Velo-Volt/MicroMod_ESP32_Processor/Hardware/modified_files/SparkFun-ESP32MicroMod/SparkFun_MicroMod_ESP32_27012021.brd

## EAGLE design Hardware/modified_files/SparkFun-ESP32MicroMod/SparkFun_MicroMod_ESP32_27012021.brd (2021-01-27)

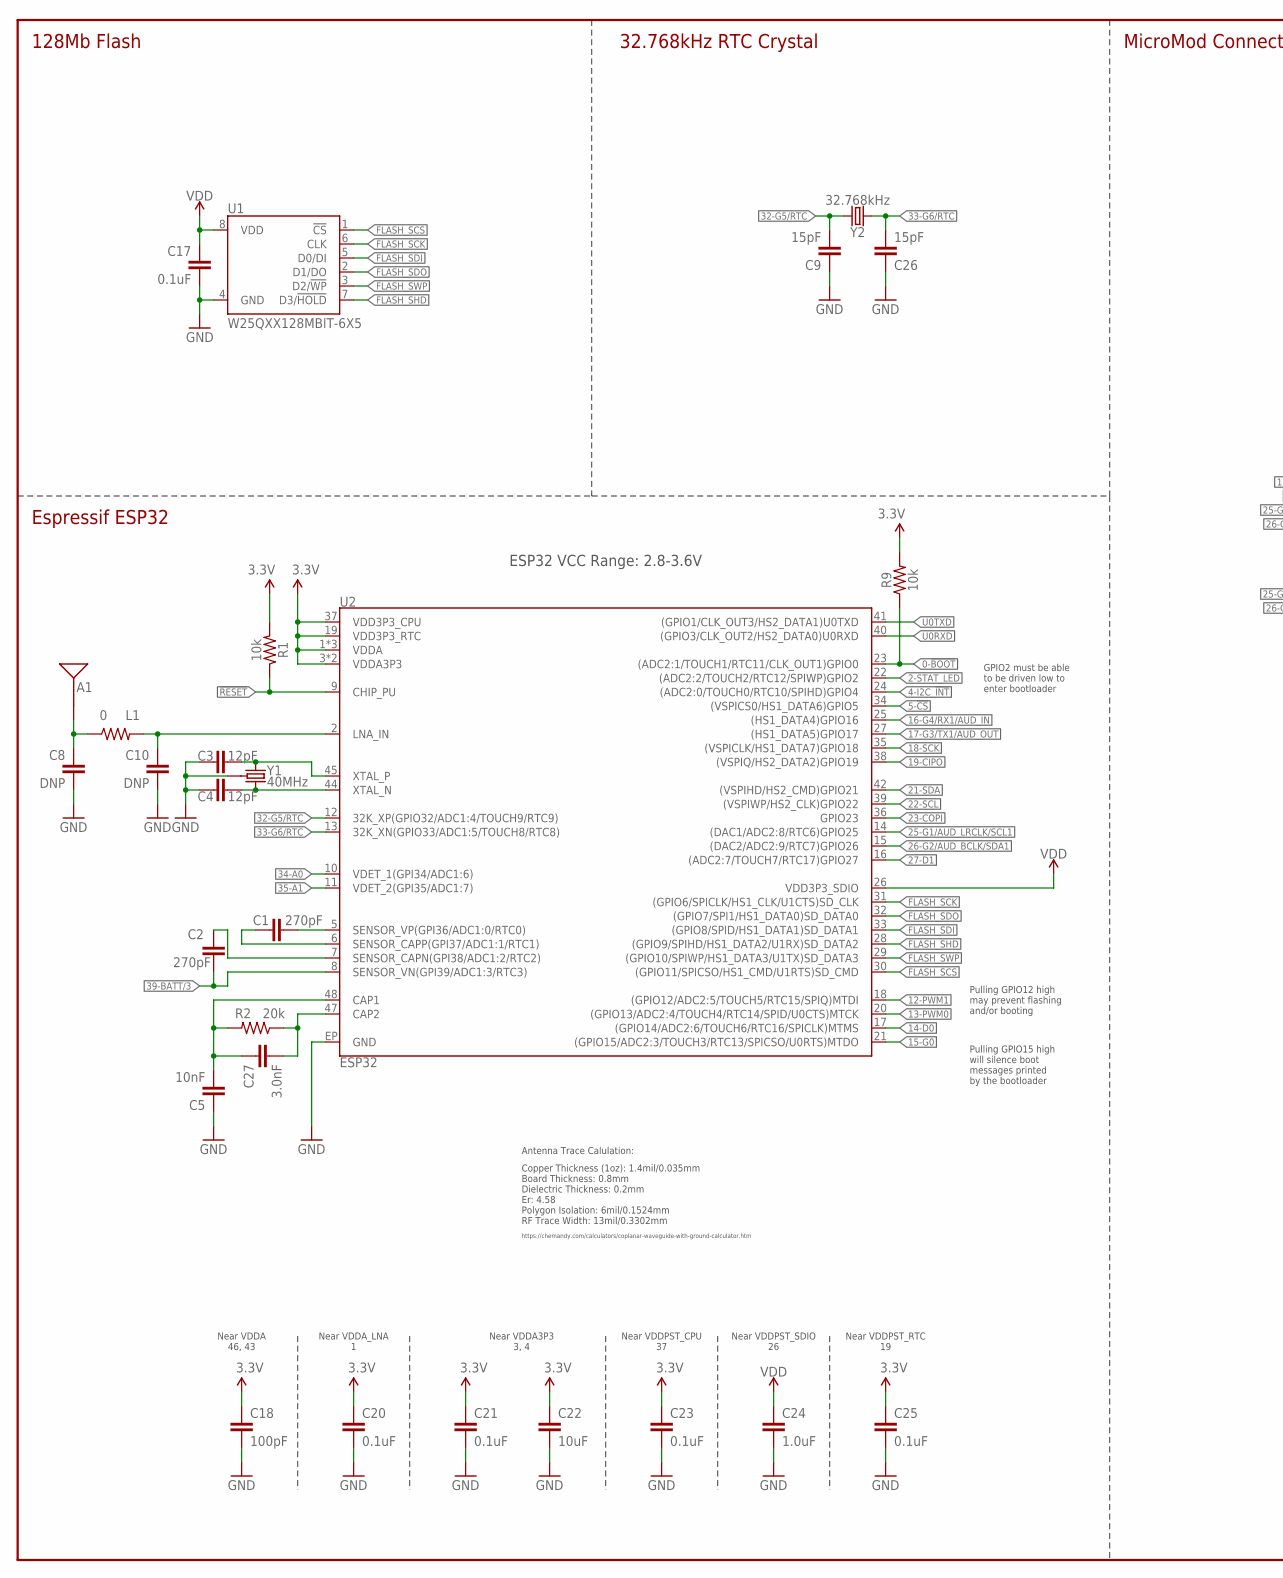
[picture p1: schematic SparkFun_MicroMod_ESP32_27012021.sch, part in row 1, column 1]

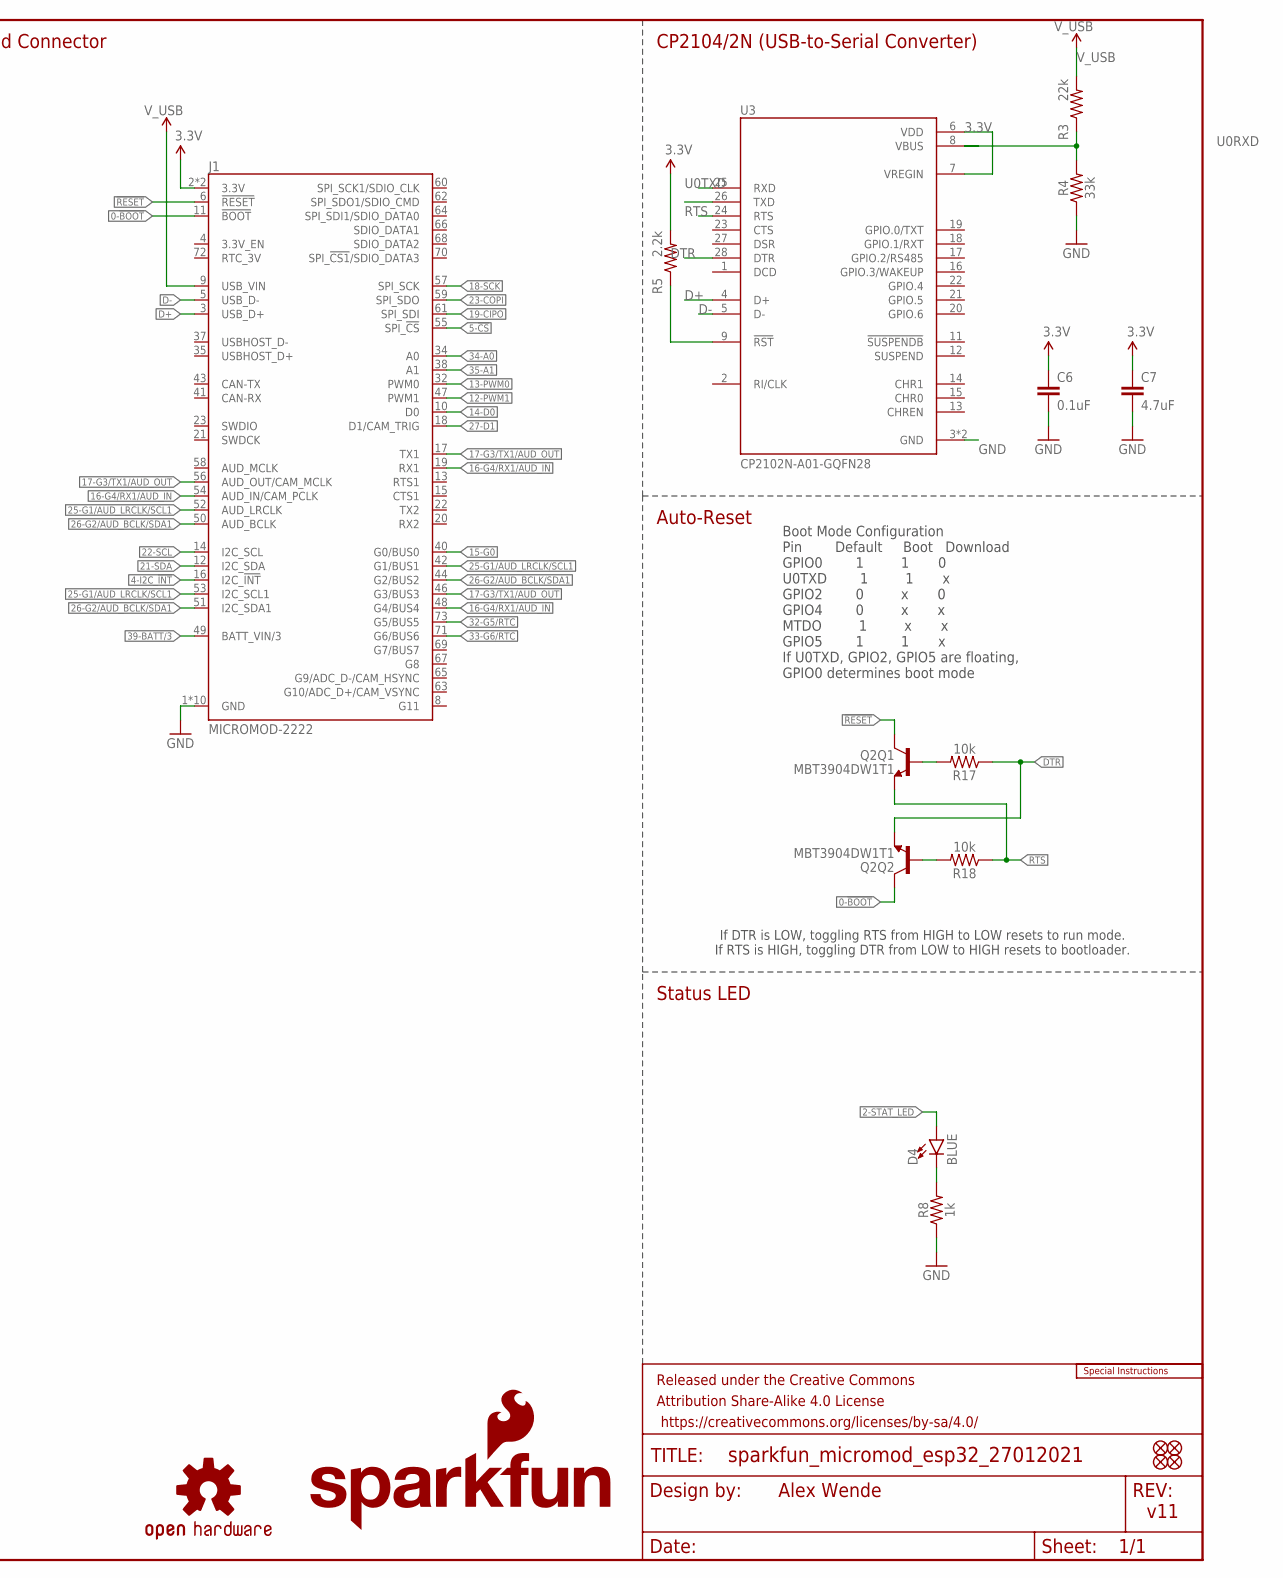
[picture p2: schematic SparkFun_MicroMod_ESP32_27012021.sch, part in row 1, column 2]

Parts:
A1: ANTENNA2.4GHZ-8.0X1.0MM; ANT-2.4GHZ-8.0X1.0MM
C1, C2: 270pF; 0402-TIGHT
C3, C4: 12pF; 0402-TIGHT
C5: 10nF; 0402-TIGHT
C6, C17, C20, C21, C23, C25: 0.1uF; 0402-TIGHT
C7: 4.7uF; 0402-TIGHT
C8, C10: DNP; 0402-TIGHT
C9, C26: 15pF; 0402-TIGHT
C18: 100pF; 0402-TIGHT
C22: 10uF; 0402-TIGHT
C24: 1.0uF; 0402-TIGHT
C27: 3.0nF; 0402-TIGHT
D4: BLUE; LED-0603
FD1, FD2, FD3, FD4: FIDUCIALUFIDUCIAL; FIDUCIAL-MICRO
FRAME1: FRAME-LEDGER; CREATIVE_COMMONS
J1: MICROMOD-2222; M.2-CARD-E-22
L1: 0; 0402-TIGHT
LOGO1: SPECIAL_INSTRUCTIONS-ORDERING; ORDERING_INSTRUCTIONS
LOGO2: SFE_LOGO_NAME_FLAME.1_INCH; SFE_LOGO_NAME_FLAME_.1
LOGO3: OSHW-LOGOS; OSHW-LOGO-S
Q2: MBT3904DW1T1; SC70-6
R1, R9, R17, R18: 10k; 0402-TIGHT
R2: 20k; 0402-TIGHT
R3: 22k; 0402-TIGHT
R4: 33k; 0402-TIGHT
R5: 2.2k; 0402-TIGHT
R8: 1k; 0402-TIGHT
U1: W25QXX128MBIT-6X5; WSON-8-6X5
U2: ESP32; QFN48-0.4MM
U3: CP2102N-A01-GQFN28; QFN50P500X500X80-29N
Y1: 40MHz; CRYSTAL-SMD-2X2.5MM
Y2: 32.768kHz; CRYSTAL-SMD-3.2X1.5MM

Connections:
0-!BOOT!: J1.11 (!BOOT!), Q2.6 (C), R9.1, U2.23 ((ADC2:1/TOUCH1/RTC11/CLK_OUT1)GPIO0)
2-STAT_LED: D4.A, U2.22 ((ADC2:2/TOUCH2/RTC12/SPIWP)GPIO2)
3.3V: C6.1, C7.1, C18.1, C20.1, C21.1, C22.1, C23.1, C25.1, J1.2 (3.3V), J1.74 (3.3V), R1.2, R5.2, R9.2, U2.1 (VDDA), U2.3 (VDDA3P3), U2.4 (VDDA3P3), U2.19 (VDD3P3_RTC), U2.37 (VDD3P3_CPU), U2.43 (VDDA), U2.46 (VDDA), U3.6 (VDD), U3.7 (VREGIN)
4-I2C_!INT: J1.16 (I2C_!INT!), U2.24 ((ADC2:0/TOUCH0/RTC10/SPIHD)GPIO4)
5-!CS: J1.55 (SPI_!CS!), U2.34 ((VSPICS0/HS1_DATA6)GPIO5)
12-PWM1: J1.47 (PWM1), U2.18 ((GPIO12/ADC2:5/TOUCH5/RTC15/SPIQ)MTDI)
13-PWM0: J1.32 (PWM0), U2.20 ((GPIO13/ADC2:4/TOUCH4/RTC14/SPID/U0CTS)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)
14-D0: J1.10 (D0), U2.17 ((GPIO14/ADC2:6/TOUCH6/RTC16/SPICLK)MTMS)
15-G0: J1.40 (G0/BUS0), U2.21 ((GPIO15/ADC2:3/TOUCH3/RTC13/SPICSO/U0RT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)
16-G4/RX1/AUD_IN: J1.19 (RX1), J1.48 (G4/BUS4), J1.54 (AUD_IN/CAM_PCLK), U2.25 ((HS1_DATA4)GPIO16)
17-G3/TX1/AUD_OUT: J1.17 (TX1), J1.46 (G3/BUS3), J1.56 (AUD_OUT/CAM_MCLK), U2.27 ((HS1_DATA5)GPIO17)
18-SCK: J1.57 (SPI_SCK), U2.35 ((VSPICLK/HS1_DATA7)GPIO18)
19-CIPO: J1.61 (SPI_SDI), U2.38 ((VSPIQ/HS2_DATA2)GPIO19)
21-SDA: J1.12 (I2C_SDA), U2.42 ((VSPIHD/HS2_CMD)GPIO21)
22-SCL: J1.14 (I2C_SCL), U2.39 ((VSPIWP/HS2_CLK)GPIO22)
23-COPI: J1.59 (SPI_SDO), U2.36 (GPIO23)
25-G1/AUD_LRCLK/SCL1: J1.42 (G1/BUS1), J1.52 (AUD_LRCLK), J1.53 (I2C_SCL1), U2.14 ((DAC1/ADC2:8/RTC6)GPIO25)
26-G2/AUD_BCLK/SDA1: J1.44 (G2/BUS2), J1.50 (AUD_BCLK), J1.51 (I2C_SDA1), U2.15 ((DAC2/ADC2:9/RTC7)GPIO26)
27-D1: J1.18 (D1/CAM_TRIG), U2.16 ((ADC2:7/TOUCH7/RTC17)GPIO27)
32-G5/RTC: C9.2, J1.73 (G5/BUS5), U2.12 (32K_XP(GPIO32/ADC1:4/TOUCH9/RTC9)), Y2.P$1 (1)
33-G6/RTC: C26.2, J1.71 (G6/BUS6), U2.13 (32K_XN(GPIO33/ADC1:5/TOUCH8/RTC8)), Y2.P$2 (2)
34-A0: J1.34 (A0), U2.10 (VDET_1(GPI34/ADC1:6))
35-A1: J1.38 (A1), U2.11 (VDET_2(GPI35/ADC1:7))
36: C1.2, U2.5 (SENSOR_VP(GPI36/ADC1:0/RTC0))
37: C1.1, U2.6 (SENSOR_CAPP(GPI37/ADC1:1/RTC1))
38: C2.1, U2.7 (SENSOR_CAPN(GPI38/ADC1:2/RTC2))
39-BATT/3: C2.2, J1.49 (BATT_VIN/3), U2.8 (SENSOR_VN(GPI39/ADC1:3/RTC3))
!RESET: J1.6 (!RESET!), Q2.3 (C), R1.1, U2.9 (CHIP_PU)
CAP_10N: C5.2, C27.1, R2.2, U2.48 (CAP1)
D+: J1.3 (USB_D+), U3.4 (D+)
D-: J1.5 (USB_D-), U3.5 (D-)
DTR: Q2.1 (E), R17.1, U3.28 (DTR)
FLASH_SCK: U1.6 (CLK), U2.31 ((GPIO6/SPICLK/HS1_CLK/U1CTS)SD_CLK)
FLASH_SCS: U1.1 (!CS!), U2.30 ((GPIO11/SPICSO/HS1_CMD/U1RTS)SD_CMD)
FLASH_SDI: U1.5 (D0/DI), U2.33 ((GPIO8/SPID/HS1_DATA1)SD_DATA1)
FLASH_SDO: U1.2 (D1/DO), U2.32 ((GPIO7/SPI1/HS1_DATA0)SD_DATA0)
FLASH_SHD: U1.7 (D3/!HOLD!), U2.28 ((GPIO9/SPIHD/HS1_DATA2/U1RX)SD_DATA2)
FLASH_SWP: U1.3 (D2/!WP!), U2.29 ((GPIO10/SPIWP/HS1_DATA3/U1TX)SD_DATA3)
GND: C3.1, C4.1, C5.1, C6.2, C7.2, C8.2, C9.1, C10.2, C17.2, C18.2, C20.2, C21.2, C22.2, C23.2, C24.2, C25.2, C26.1, J1.1 (GND), J1.7 (GND), J1.33 (GND), J1.36 (GND), J1.39 (GND), J1.45 (GND), J1.75 (GND), J1.GND1 (GND), J1.GND2 (GND), J1.GND3 (GND), R4.1, R8.1, U1.4 (GND), U2.EP (GND), U3.3 (GND), U3.29 (GND), Y1.P2 (GND), Y1.P4 (GND)
unnamed: D4.C, R8.2
unnamed: C27.2, R2.1, U2.47 (CAP2)
unnamed: A1.FEED, C8.1, L1.1
unnamed: C10.1, L1.2, U2.2 (LNA_IN)
unnamed: Q2.5 (B), R17.2
unnamed: Q2.2 (B), R18.2
unnamed: C3.2, U2.45 (XTAL_P), Y1.P1 (1)
unnamed: C4.2, U2.44 (XTAL_N), Y1.P3 (2)
unnamed: R5.1, U3.9 (!RST)
unnamed: R3.1, R4.2, U3.8 (VBUS)
RTS: Q2.4 (E), R18.1, U3.24 (RTS)
U0RXD: U2.40 ((GPIO3/CLK_OUT2/HS2_DATA0)U0RXD), U3.26 (TXD)
U0TXD: U2.41 ((GPIO1/CLK_OUT3/HS2_DATA1)U0TXD), U3.25 (RXD)
VDD: C17.1, C24.1, U1.8 (VDD), U2.26 (VDD3P3_SDIO)
V_USB: J1.9 (USB_VIN), R3.2

Notes on the sheet:
Boot Mode Configuration Pin Default Boot Download GPIO0 1 1 0 U0TXD 1 1 x GPIO2 0 x 0 GPIO4 0 x x MTDO 1 x x GPIO5 1 1 x If U0TXD, GPIO2, GPIO5 are floating, GPIO0 determines boot mode
Auto-Reset
Near VDDA 46, 43
Near VDDA_LNA 1
Near VDDA3P3 3, 4
Near VDDPST_CPU 37
Near VDDPST_SDIO 26
Near VDDPST_RTC 19
Espressif ESP32
128Mb Flash
32.768kHz RTC Crystal
Status LED
v11
Alex Wende
ESP32 VCC Range: 2.8-3.6V
If DTR is LOW, toggling RTS from HIGH to LOW resets to run mode. If RTS is HIGH, toggling DTR from LOW to HIGH resets to bootloader.
CP2104/2N (USB-to-Serial Converter)
MicroMod Connector
Antenna Trace Calulation:
Copper Thickness (1oz): 1.4mil/0.035mm Board Thickness: 0.8mm Dielectric Thickness: 0.2mm Er: 4.58 Polygon Isolation: 6mil/0.1524mm RF Trace Width: 13mil/0.3302mm
https://chemandy.com/calculators/coplanar-waveguide-with-ground-calculator.htm
GPIO2 must be able to be driven low to enter bootloader
Pulling GPIO12 high may prevent flashing and/or booting
Pulling GPIO15 high will silence boot messages printed by the bootloader

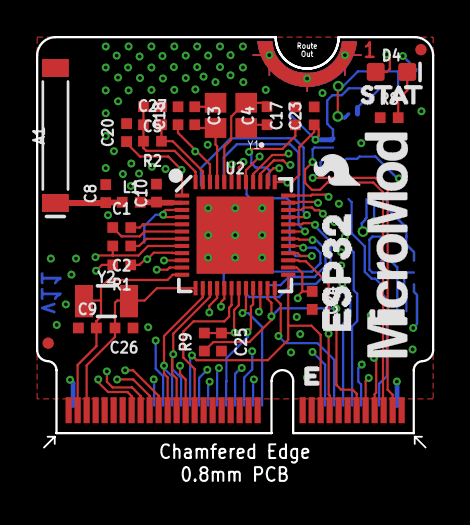
[picture p3: board SparkFun_MicroMod_ESP32_27012021.brd from above]

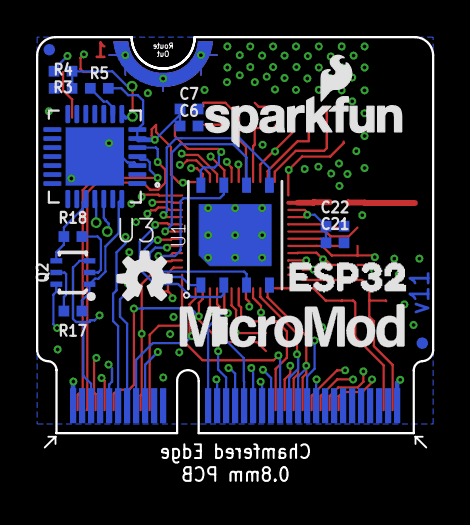
[picture p4: board SparkFun_MicroMod_ESP32_27012021.brd from below]

Board: 4 copper layers, 22.0 x 22.8 mm, 53 parts (18 on the bottom side), 54 nets.

Other parts of the board:
U$1: STAT0
U$2, U$6: MICROMOD_LOGO_.5
U$3, U$7: ESP321
U$4: SFE_LOGO_FLAME_.1
